FYQD-ui/electronic_load/pcb/ad360b59-4d75-4cc4-ad27-5cc6b6af0da9.png

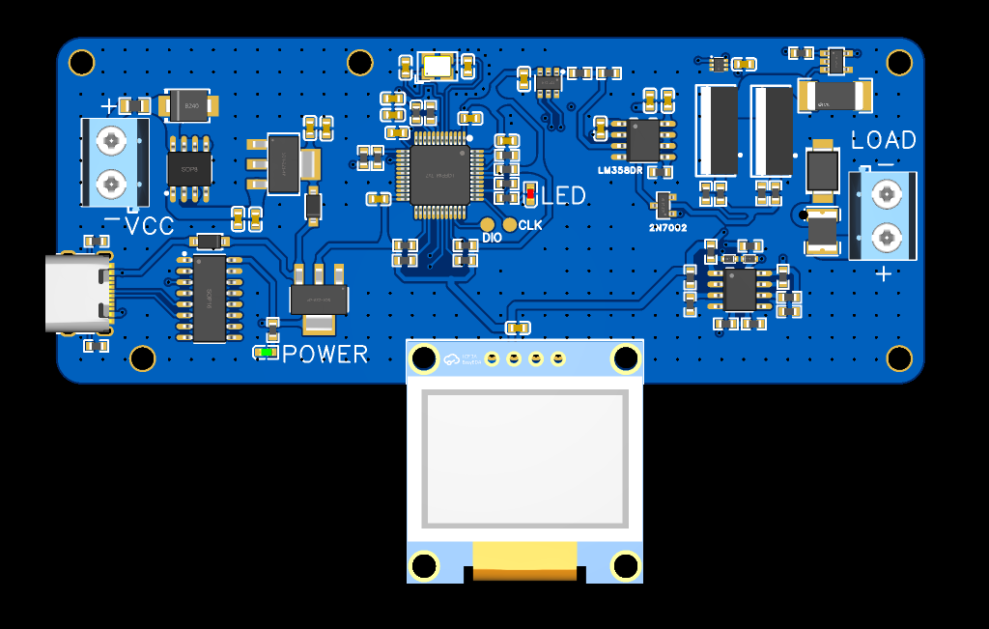
pcb/ad360b59-4d75-4cc4-ad27-5cc6b6af0da9.png
