FYQD-ui/electronic_load/pcb/SCH_Schematic1_2026-06-24.pdf

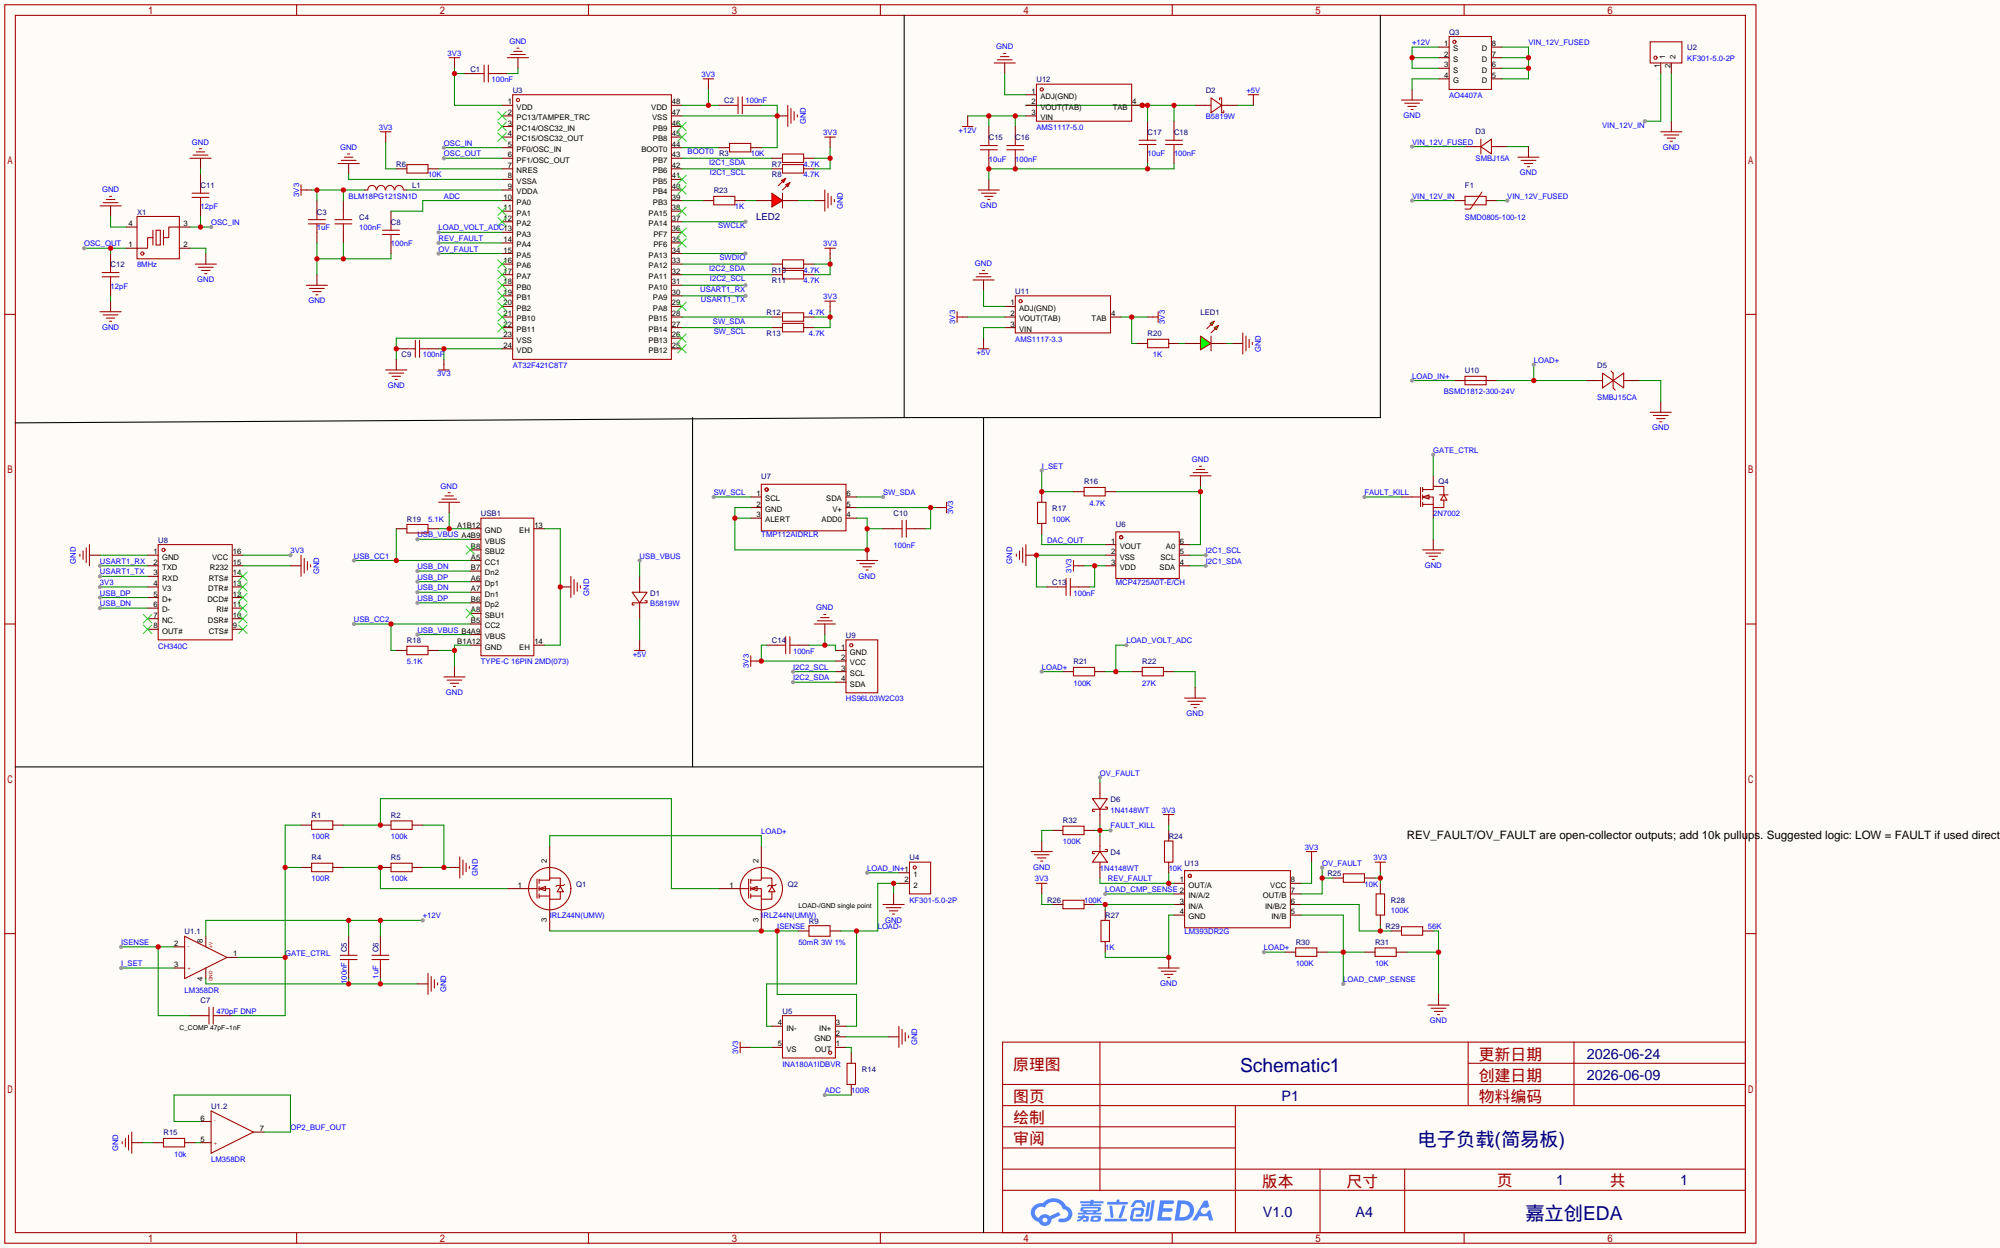
[picture p2: page 1]

DSR# 10 RI# 11 DCD# 12 DTR# 13 RTS# 14 R232 15 VCC 16

REV_FAULT/OV_FAULT are open-collector outputs; add 10k pullups. Suggested logic: LOW = FAULT if used directly.

LOAD-/GND single point
