FYQD-ui/electronic_load/project/inc/at32f421_wk_config.h

/* add user code begin Header */
/**
  **************************************************************************
  * @file     at32f421_wk_config.h
  * @brief    header file of work bench config
  **************************************************************************
  * Copyright (c) 2025, Artery Technology, All rights reserved.
  *
  * The software Board Support Package (BSP) that is made available to
  * download from Artery official website is the copyrighted work of Artery.
  * Artery authorizes customers to use, copy, and distribute the BSP
  * software and its related documentation for the purpose of design and
  * development in conjunction with Artery microcontrollers. Use of the
  * software is governed by this copyright notice and the following disclaimer.
  *
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
  **************************************************************************
  */
/* add user code end Header */

/* define to prevent recursive inclusion -----------------------------------*/
#ifndef __AT32F421_WK_CONFIG_H
#define __AT32F421_WK_CONFIG_H

#ifdef __cplusplus
extern "C" {
#endif

/* includes -----------------------------------------------------------------------*/
#include "stdio.h"
#include "at32f421.h"

/* private includes -------------------------------------------------------------*/
/* add user code begin private includes */

/* add user code end private includes */

/* exported types -------------------------------------------------------------*/
/* add user code begin exported types */

/* add user code end exported types */

/* exported constants --------------------------------------------------------*/
/* add user code begin exported constants */

/* add user code end exported constants */

/* exported macro ------------------------------------------------------------*/
/* add user code begin exported macro */

/* add user code end exported macro */

/* add user code begin dma define */
/* user can only modify the dma define value */
#define DMA1_CHANNEL1_BUFFER_SIZE   0
#define DMA1_CHANNEL1_MEMORY_BASE_ADDR   0
//#define DMA1_CHANNEL1_PERIPHERAL_BASE_ADDR  0

//#define DMA1_CHANNEL2_BUFFER_SIZE   0
//#define DMA1_CHANNEL2_MEMORY_BASE_ADDR   0
//#define DMA1_CHANNEL2_PERIPHERAL_BASE_ADDR   0

//#define DMA1_CHANNEL3_BUFFER_SIZE   0
//#define DMA1_CHANNEL3_MEMORY_BASE_ADDR   0
//#define DMA1_CHANNEL3_PERIPHERAL_BASE_ADDR   0

//#define DMA1_CHANNEL4_BUFFER_SIZE   0
//#define DMA1_CHANNEL4_MEMORY_BASE_ADDR   0
//#define DMA1_CHANNEL4_PERIPHERAL_BASE_ADDR   0

//#define DMA1_CHANNEL5_BUFFER_SIZE   0
//#define DMA1_CHANNEL5_MEMORY_BASE_ADDR   0
//#define DMA1_CHANNEL5_PERIPHERAL_BASE_ADDR   0
/* add user code end dma define */

/* Private defines -------------------------------------------------------------*/
#define LOAD_VOLT_ADC_PIN    GPIO_PINS_3
#define LOAD_VOLT_ADC_GPIO_PORT    GPIOA
#define REV_FAULT_PIN    GPIO_PINS_4
#define REV_FAULT_GPIO_PORT    GPIOA
#define OV_FAULT_PIN    GPIO_PINS_5
#define OV_FAULT_GPIO_PORT    GPIOA
#define SW_SCL_PIN    GPIO_PINS_14
#define SW_SCL_GPIO_PORT    GPIOB
#define SW_SDA_PIN    GPIO_PINS_15
#define SW_SDA_GPIO_PORT    GPIOB
#define LED_PIN    GPIO_PINS_3
#define LED_GPIO_PORT    GPIOB

/* exported functions ------------------------------------------------------- */
  /* system clock config. */
  void wk_system_clock_config(void);

  /* config periph clock. */
  void wk_periph_clock_config(void);

  /* nvic config. */
  void wk_nvic_config(void);

/* add user code begin exported functions */

/* add user code end exported functions */

#ifdef __cplusplus
}
#endif

#endif
