FYQD-ui/electronic_load/(commit log)

2026-06-24 新增加PCB硬件原理图
2026-06-24 更新pcb文件
2026-06-24 add PCB design package
